stephenpapierski/led_dice/doc/finite_state_machines/piezo_debounce_FSM.jpg

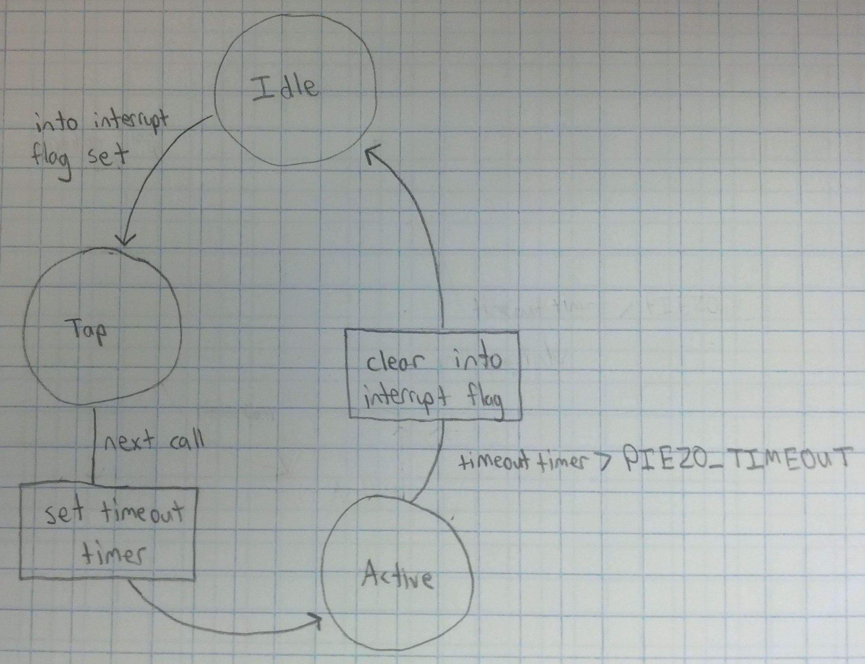
doc/finite_state_machines/piezo_debounce_FSM.jpg
