stephenpapierski/led_dice/doc/finite_state_machines/dice_UI_FSM.jpg

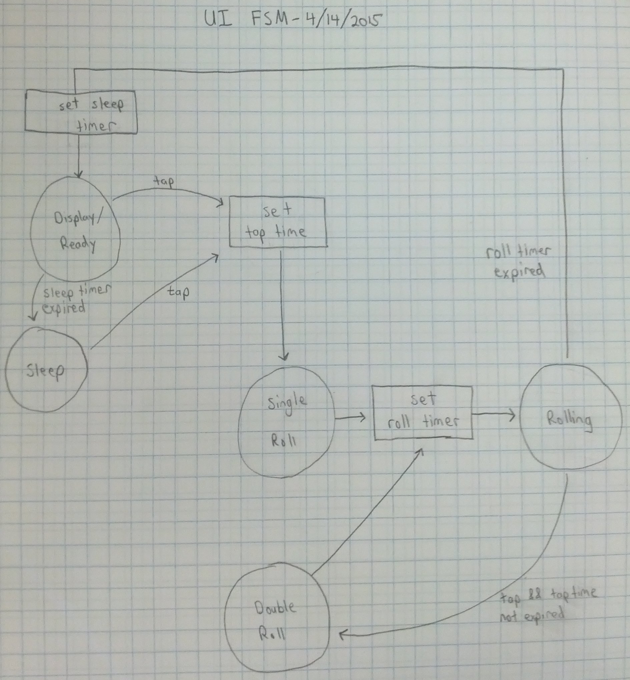
doc/finite_state_machines/dice_UI_FSM.jpg
