stephenpapierski/led_dice/README.md

# led_dice
Embedded code for an LED dice running on an ATtiny85
