stephenpapierski/led_dice/doc/eagle_pcb/board.png

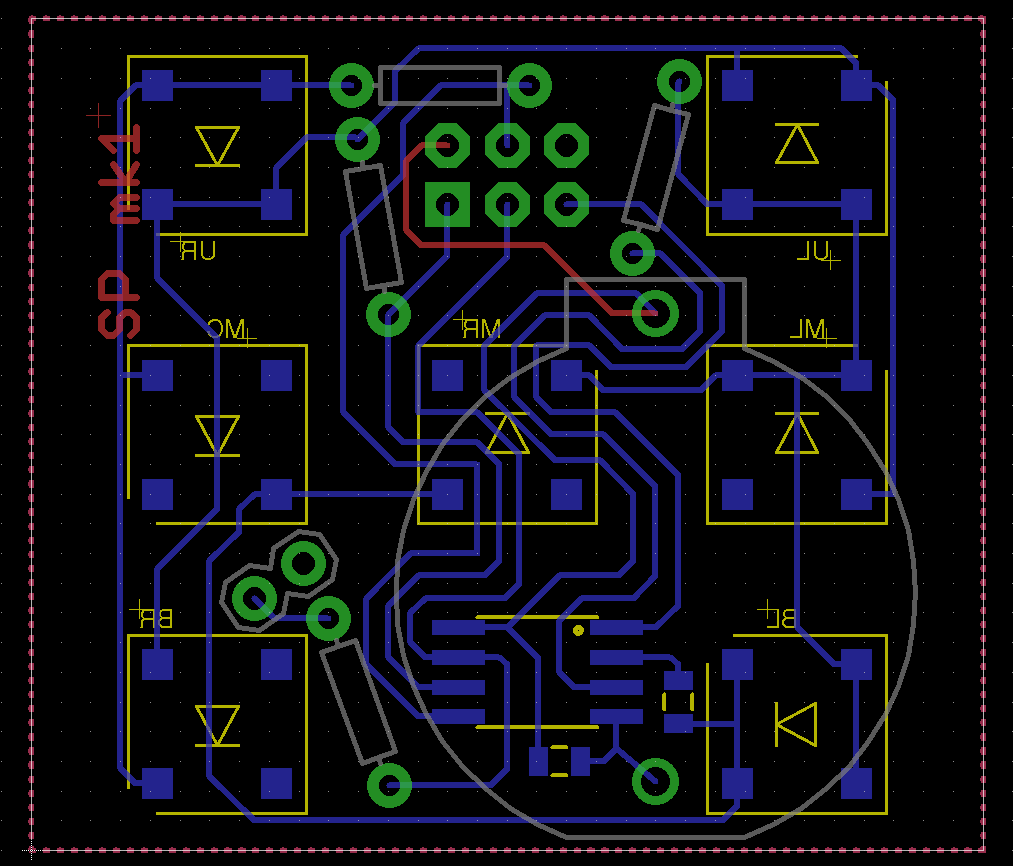
doc/eagle_pcb/board.png
