stephenpapierski/led_dice/doc/eagle_pcb/schematic.png

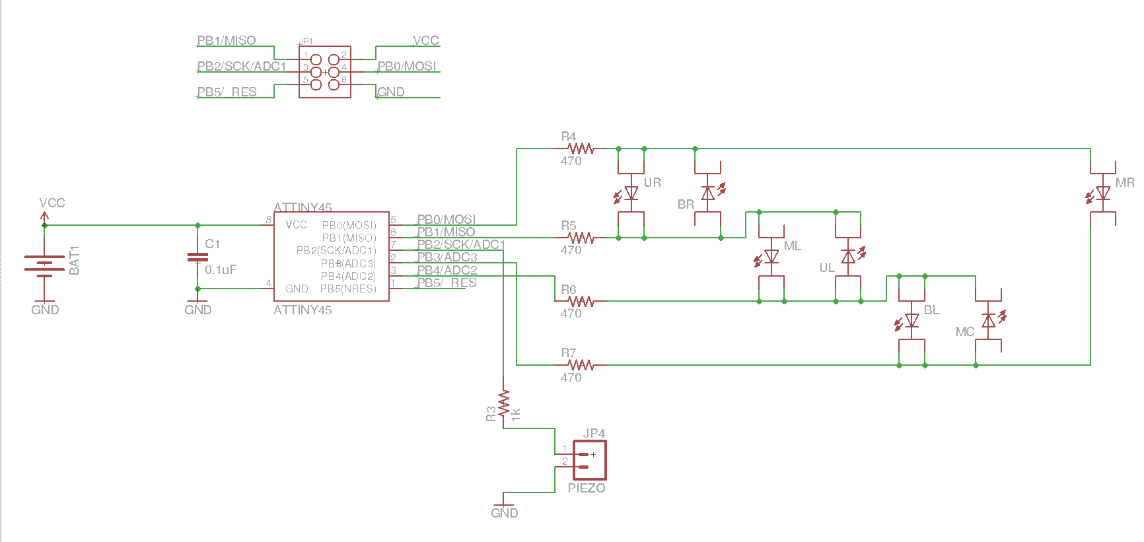
doc/eagle_pcb/schematic.png
