stephenpapierski/led_dice/doc/project_notes.jpg

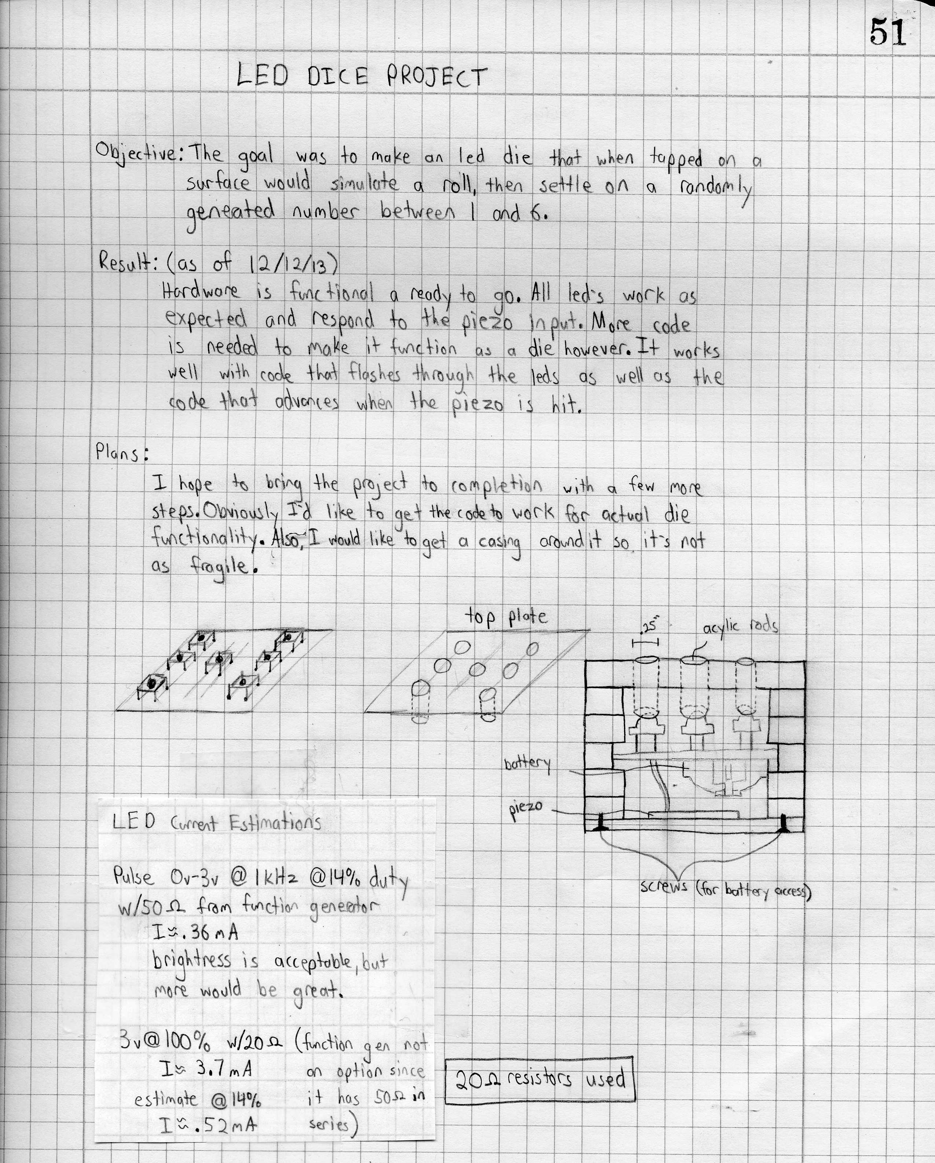
doc/project_notes.jpg
