stephenpapierski/led_dice/(list of files, cad)

Other CAD files:
doc/acrylic_case.dwg
