stephenpapierski/led_dice/doc/eagle_pcb/Papierski_Dice_3.brd

## EAGLE design doc/eagle_pcb/Papierski_Dice_3.brd (2015-04-12)

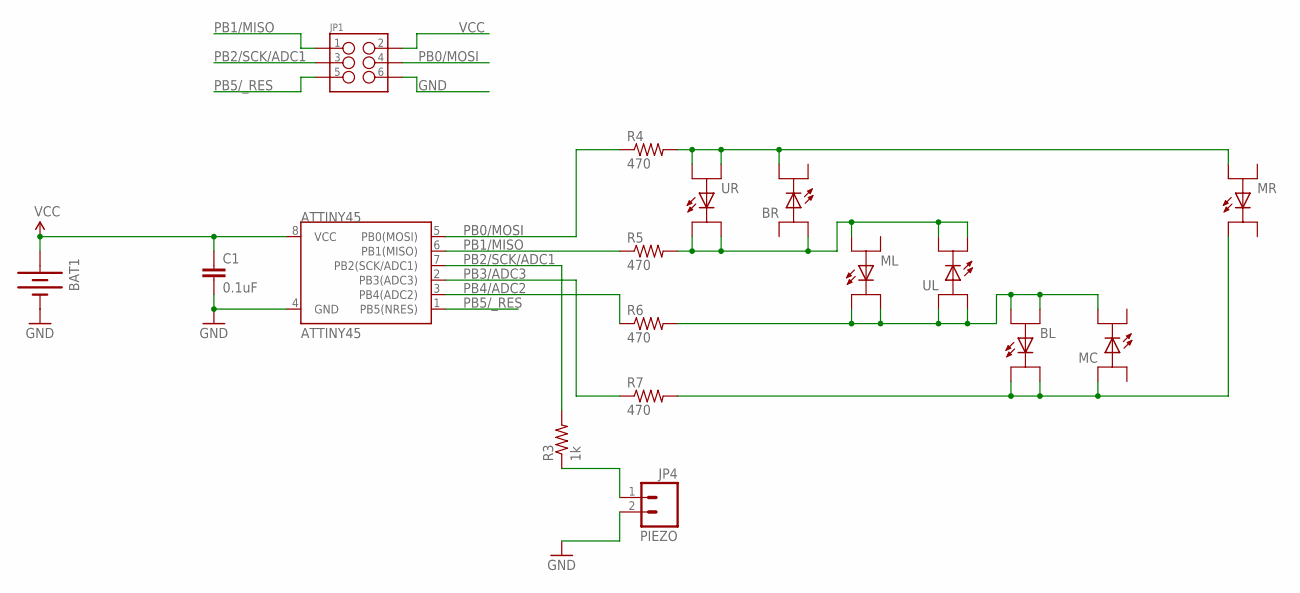
[picture p6: schematic Papierski_Dice_3.sch]

Parts:
ATTINY45: ATTINY45; SO08-EIAJ
BAT1: BATTERY20PTH; BATTCOM_20MM_PTH
BL: LED_PIRANHA_5MM_SNGLS; LED_PIRANHA_5MM_SNGL_SMD
BR: LED_PIRANHA_5MM_SNGLS; LED_PIRANHA_5MM_SNGL_SMD
C1: 0.1uF; 0805
JP1: M03X2NO_SILK; 2X3-NS
MC: LED_PIRANHA_5MM_SNGLS; LED_PIRANHA_5MM_SNGL_SMD
ML: LED_PIRANHA_5MM_SNGLS; LED_PIRANHA_5MM_SNGL_SMD
MR: LED_PIRANHA_5MM_SNGLS; LED_PIRANHA_5MM_SNGL_SMD
PIEZO: JP4; 1X02
R3: 1k; AXIAL-0.3
R4, R5, R6: 470; AXIAL-0.3
R7: 470; 0805
UL: LED_PIRANHA_5MM_SNGLS; LED_PIRANHA_5MM_SNGL_SMD
UR: LED_PIRANHA_5MM_SNGLS; LED_PIRANHA_5MM_SNGL_SMD

Connections:
GND: ATTINY45.4 (GND), BAT1.2 (-), C1.2, JP1.6, PIEZO.2
unnamed: BR.K1 (C1), MR.A1, R4.P$2 (2), UR.A1, UR.A2
unnamed: BL.A1, BL.A2, MC.K1 (C1), ML.K1 (C1), ML.K2 (C2), R6.P$2 (2), UL.A1, UL.A2
unnamed: BL.K1 (C1), BL.K2 (C2), MC.A2, MR.K2 (C2), R7.2
unnamed: PIEZO.1, R3.P$1 (1)
unnamed: BR.A1, ML.A1, R5.P$2 (2), UL.K1 (C1), UL.K2 (C2), UR.K1 (C1), UR.K2 (C2)
PB0/MOSI: ATTINY45.5 (PB0(MOSI)), JP1.4, R4.P$1 (1)
PB1/MISO: ATTINY45.6 (PB1(MISO)), JP1.1, R5.P$1 (1)
PB2/SCK/ADC1: ATTINY45.7 (PB2(SCK/ADC1)), JP1.3, R3.P$2 (2)
PB3/ADC3: ATTINY45.2 (PB3(ADC3)), R7.1
PB4/ADC2: ATTINY45.3 (PB4(ADC2)), R6.P$1 (1)
PB5/_RES: ATTINY45.1 (PB5(NRES)), JP1.5
VCC: ATTINY45.8 (VCC), BAT1.1 (+), C1.1, JP1.2

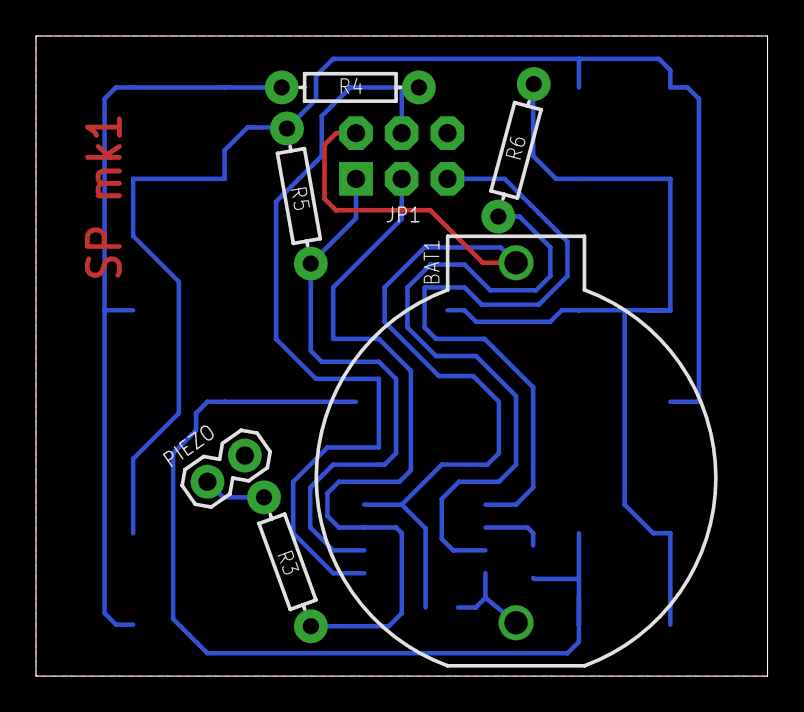
[picture p7: board Papierski_Dice_3.brd from above]

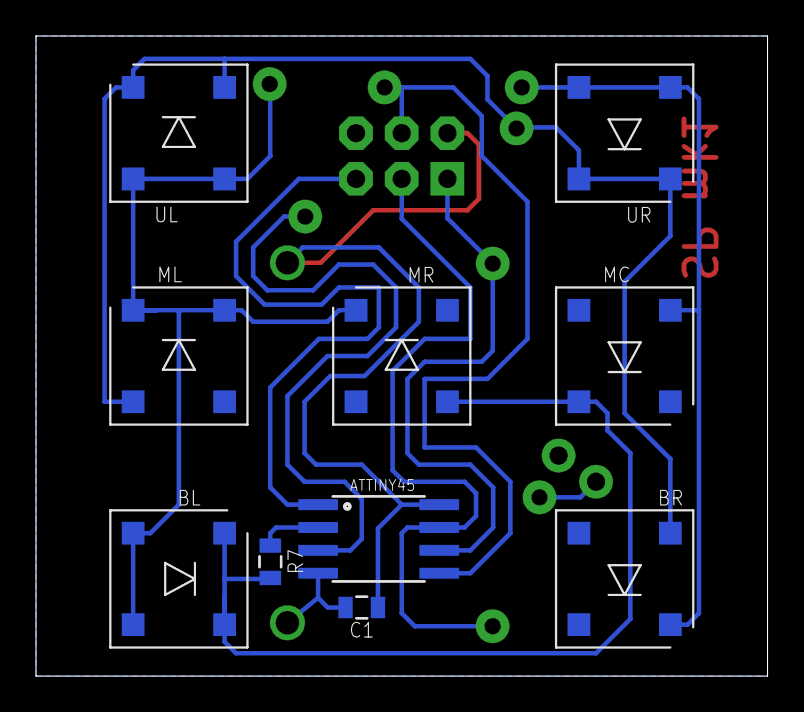
[picture p8: board Papierski_Dice_3.brd from below]

Board: 2 copper layers, 40.6 x 35.6 mm, 17 parts (10 on the bottom side), 13 nets.
