stephenpapierski/led_dice/src/myModules.h

/**
 *
 * @file    myModules.h
 * @author  Stephen Papierski <stephenpapierski@gmail.com>
 * @date    2015-03-23 09:35:13
 * @edited  2015-04-18 01:45:59
 */

#ifndef MYMODULES_H
#define MYMODULES_H

#include "led/led.h"
#include "timer/tmr.h"
#include "interrupts/intr.h"
#include "piezo/piezo.h"
#include "power/pwr.h"
#include "dice/dice.h"

#endif //MYMODULES_H
