stephenpapierski/led_dice/(commit log)

2015-02-28 Set up Timer0 and PIEZO External interrupts, and general structure set up
2015-04-04 Electronic/mechanical project files added
    [Papierski_Dice_3.brd, Papierski_Dice_3.sch, acrylic_case.dwg]
2015-04-07 Added switch debounce
2015-04-12 Updated schematic to specify where each led was physically
    [Papierski_Dice_3.brd, Papierski_Dice_3.sch]
2015-04-12 Added image files of schematic and board
2015-04-16 Enabled MCU power-down for power saving
2015-04-18 Cleaned up main loop, added power and dice library
